squishykid/particles/README.md

# Particulate and Environment Sensor

ESP8266 and ESPHome based sensor unit

## Sensors

- PMS7003 Particulate Sensor (including PM2.5)
- SenseAir S8

## Directories

- `particle_sensor_pcb` - CAD files for pcb
- `src` - ESPHome config/code
