squishykid/particles/particle_sensor_pcb/particle_sensor_pcb.kicad_pcb

## KiCad design particle_sensor_pcb/particle_sensor_pcb.kicad_pcb (2022-10-23)

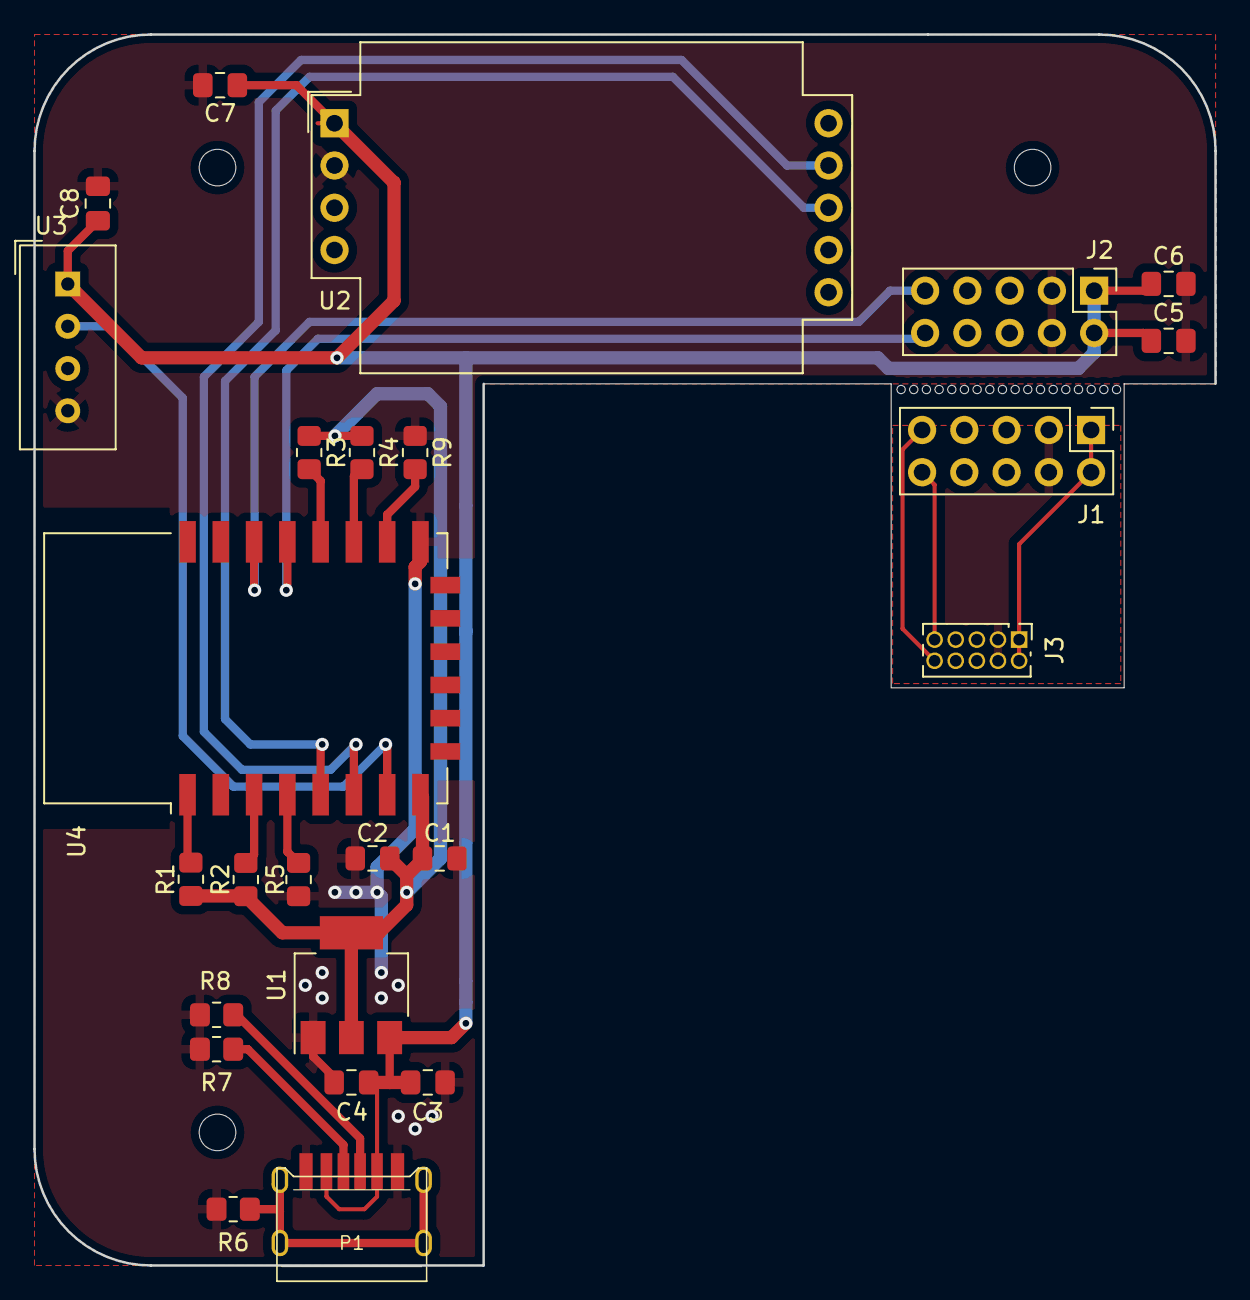
[picture p1: board particle_sensor_pcb.kicad_pcb from above]

Board: 2 copper layers, 71.0 x 74.0 mm, 25 parts (0 on the bottom side), 21 nets.

Parts:
C1, C4: 100nF; C_0805_2012Metric_Pad1.18x1.45mm_HandSolder
C2, C3, C5, C6, C7, C8: 22uF; C_0805_2012Metric_Pad1.18x1.45mm_HandSolder
J1: DST_JUMP; PinHeader_2x05_P2.54mm_Vertical
J2: SRC_JUMP; PinHeader_2x05_P2.54mm_Vertical
J3: PMS7003; PinSocket_2x05_P1.27mm_Vertical
P1: USB_C_; TYPE-C-31-M-17_handsolder
R1, R2, R3, R4, R5, R7, R8, R9: 12K; R_0805_2012Metric_Pad1.20x1.40mm_HandSolder
R6: 1M; R_0805_2012Metric_Pad1.20x1.40mm_HandSolder
U1: AMS1117-3.3; SOT-223-3_TabPin2
U2: 004-0-0053; Senseair_S8_Up
U3: DHT11; Aosong_DHT11_5.5x12.0_P2.54mm
U4: ESP-12F; ESP-12E

Connections:
+3V3: C1.1, C2.1, R1.2, R2.2, R3.1, R4.1, U1.2 (VO), U4.8 (VCC)
+5V: C3.1, C4.1, C5.1, C6.1, C7.1, C8.1, J2.1, J2.2, P1.A9 (VBUS), P1.B9 (VBUS), U1.3 (VI), U2.1 (G+), U3.1 (VCC)
+5V_JMP: J1.1, J1.2, J3.1, J3.2
/CC1: P1.A5 (CC1), R7.2
/CC2: P1.B5 (CC2), R8.1
/SHIELD: P1.S1 (SHIELD), R6.2
D1: J2.9, U4.20 (GPIO5)
D1_JMP: J1.9, J3.10
D2: J2.10, U4.19 (GPIO4)
D2_JMP: J1.10, J3.9
D5: U2.7 (UART_TXD), U4.5 (GPIO14)
D6: U2.8 (UART_RXD), U4.6 (GPIO12)
D7: U3.2 (IO), U4.7 (GPIO13)
GND: C1.2, C2.2, C3.2, C4.2, C5.2, C6.2, C7.2, C8.2, J2.3, J2.4, P1.A12 (GND), P1.B12 (GND), R5.1, R6.1, R7.1, R8.2, R9.1, U1.1 (GND), U2.2 (G0), U3.4 (GND), U4.15 (GND)
GND_JMP: J1.3, J1.4, J3.3, J3.4
unnamed: R1.1, U4.1 (~RST)
unnamed: R2.1, U4.3 (EN)
unnamed: R3.2, U4.18 (GPIO0)
unnamed: R4.2, U4.17 (GPIO2)
unnamed: R5.2, U4.4 (GPIO16)
unnamed: R9.2, U4.16 (GPIO15)
