squishykid/particles/(threads)

Thread 3 (2022-10-09):

Fix bodge resistor beteen pin 16 and gnd

squishykid, 2022-10-09:
