squishykid/particles/src/particulate_sensor.yaml

esphome:
  name: "particulate"
  name_add_mac_suffix: True
  platform: ESP8266
  board: d1_mini

# Enable logging
logger:

# Enable Home Assistant API
api:
  password: ""

ota:
  password: ""

wifi:
  # Enable fallback hotspot (captive portal) in case wifi connection fails
  ap:
    password: "particles"

captive_portal:
uart:
  - rx_pin: GPIO4
    baud_rate: 9600
    id: pms_uart
  - rx_pin: GPIO14
    tx_pin: GPIO12
    baud_rate: 9600
    id: sensair_uart

globals:
  - id: pm_25_measurements
    type: float[32]
    restore_value: no
  - id: pm_25_sample_count
    type: size_t
    restore_value: no
    initial_value: '0'

sensor:
  - platform: senseair
    co2:
      name: "CO₂ Concentration"
    update_interval: 60s
    uart_id: sensair_uart
  - platform: pmsx003
    type: PMSX003
    uart_id: pms_uart
    pm_1_0:
      name: "Particulate Matter <1.0µm Concentration Raw"
      id: pm_1_raw
      internal: true
    pm_2_5:
      name: "Particulate Matter <2.5µm Concentration Raw"
      id: pm_25_raw
      internal: true
      on_value:
        then:
          - lambda: |-
              if (!id(pms_warm).state) {
                return;
              }
              static bool pms_warm_previous_state;
              bool pms_warm_current_state = id(pms_warm).state;

              // reset index to 0 on edge from cold to warm
              if (pms_warm_current_state && !pms_warm_previous_state) {
                id(pm_25_sample_count) = 0;
              } else {
                id(pm_25_sample_count) += 1;
              }
              // store measurement
              id(pm_25_measurements)[id(pm_25_sample_count) % 32] = id(pm_25_raw).state;
              pms_warm_previous_state = pms_warm_current_state;
    pm_10_0:
      name: "Particulate Matter <10.0µm Concentration Raw"
      id: pm_10_raw
      internal: true

  - platform: template
    name: "Pm25"
    id: pm_25
    icon: mdi:molecule
    unit_of_measurement: "µg/m³"
    accuracy_decimals: 1

switch:
  - platform: gpio
    pin:
      number: GPIO5
      inverted: no
    id: pms_set
    name: "Particulate Matter Sensor Enabled"
    internal: true

interval:
#Controls Sleep Interval by turning on/off above switch
  - interval: 300s
    then:
      - switch.turn_on: pms_set
      - delay: 60s
      - switch.turn_off: pms_set

binary_sensor:
  - platform: template
    name: "Particulate Matter Sensor Warm"
    id: pms_warm
    internal: true
    lambda: |-
      if (id(pms_set).state) {
        return true;
      } else {
        return false;
      }
    filters:
      - delayed_on: 30s
    on_release:
      then:
        - lambda: |-
            ESP_LOGD("pm_x_calc", "Measurement collection complete. Updating synthesised sensors.");

            // PM25
            // figure out how many measurements to average
            size_t avg_over_25 = std::min(id(pm_25_sample_count), (size_t)32);
            if (avg_over_25 < 1) {
              ESP_LOGE("pm_x_calc", "did not receive any pm25 samples, is sensor reporting values?");
              id(pm_25).publish_state(NAN);
              return;
            }
            // average reading and publish to template sensor
            float sum_25 = 0.0;
            for (size_t i = 0; i < avg_over_25; i++) {
              sum_25 += id(pm_25_measurements)[i];
            }
            id(pm_25_sample_count) = 0; // reset sample count
            id(pm_25).publish_state(sum_25 / avg_over_25); // update sensor with results
