squishykid/particles/(commit log)

2022-01-16 version 1.0
    [particle_sensor_pcb.csv, particle_sensor_pcb.kicad_pcb, particle_sensor_pcb.sch]
2022-01-16 removed temp files
    [particle_sensor_pcb.kicad_pcb]
2022-10-23 USB-C connector, fix bodge, add jumper board
    [particle_sensor_pcb.kicad_pcb, particle_sensor_pcb.kicad_sch, particle_sensor_pcb.sch]
